Jinbae10/atmega128-drone/BLDC/v1/parts_list.md

# 부품 목록 (BLDC v1, 3S)

- 기준일: 2026-11-06. 소자 값·수량은 회로도 [drone_v1.kicad_sch](drone_v1.kicad_sch) 기준입니다.
- 가격은 디바이스마트 화면 표시 금액이며, 부가세 별도일 가능성이 있습니다. 재고와 가격은 주문 시 다시 확인해야 합니다.
- 칩 크기는 미터 표기(인치 표기)입니다. 예: 2012(0805).

## 1. 구매할 납땜 소자 (디바이스마트)

| 소자 | 값·정격 | 크기 | 필요 수량 | 회로도 번호 | 품목 | 판매 단위 | 가격 |
|---|---|---|---|---|---|---|---|
| 칩저항 | 10k ±1% (F급) | 2012 | 7 | R1, R2, R14, R4~R7 | TA-I | 100개 | 약 500원 |
| 칩저항 | 1k ±5% (J급) | 2012 | 2 | R3, R12 | TA-I | 100개 | 약 500원 |
| 칩저항 | 2k ±5% (J급) | 2012 | 1 | R13 | TA-I | 100개 | 약 500원 |
| 칩저항 | 100Ω ±5% (J급) | 2012 | 4 | R8~R11 | TA-I | 100개 | 약 500원 |
| MLCC | 100nF | 3216 (1206) | 5 | C3~C7 | 미정 | 100개 | 약 1,900원 |
| 폴리퓨즈 | 0.5A 24V | 3216 (1206) | 1 | F1 | FSMD050-24-1206R | 10개 | 약 1,100원 |
| 쇼트키 다이오드 | BAT54 | SOT-23 | 1 | D1 | Diotec (재판매, 5~7일) | 미확인 | 240원 |
| 전해 커패시터 | 100µF 35V | 스루홀 Ø6.3×11mm, 핀 간격 2.5mm | 2 | C1, C2 | 미정 | 10개 | 약 400원 |
| 슬라이드 스위치 | SPDT 약 0.3A | 스루홀 약 8.7×4.5mm, 핀 간격 2.54mm (미확인) | 1 | SW1 | SS-12D02 | 낱개 | 150원 |
| 핀헤더 | 2.54mm 1×40 | 스루홀 | 1줄 (11핀 사용) | J1, J3, U1 장착용 | 미정 | 낱개 | 200원 |

20k 칩저항은 소량 구매가 어려워 10k 두 개를 직렬로 씁니다(R1 + R14).

## 2. 구매할 모듈·기타 (디바이스마트)

| 부품 | 수량 | 크기 | 품목 | 가격 | 비고 |
|---|---|---|---|---|---|
| MPU-6050 GY-521 | 1 | 약 21×16×3mm | | 4,950원 | 10월 17일 가격. 최근 검색 화면은 4,500원 |
| HC-06 DIP 슬레이브 | 1 | 약 37×17mm (미확인) | SZH-EK105 | 6,050원 | 10월 17일 가격. 최근 검색 화면은 5,500원 |
| MP1584 강압 모듈 | 1 | 약 22×17×4mm (패드 간격 미확인) | VLT-VC042 | 1,800원 | 핀헤더로 PCB에 장착 |
| XT60 암수 세트 | 2 | | | 3,200원 | 2세트 합계로 계산함. 주문 시 확인 |
| 14AWG 실리콘 전선 | 1m | | DFROBOT FIT0583 | 약 9,800원 | 모터 전류 경로 |
| 벨크로 타이 | 1 | | SZ-XL036 | 900원 | 배터리 고정 |
| M3 나사 | 100개 | M3×5 확인, 길이는 모터 실측 후 결정 | | 약 1,000원 | 프레임 확인 후 구매 |
| 열수축 튜브 | 소량 | 지름은 전선에 맞춰 선택 | | 미확인 | |
| 3S LiPo | 1 | 미확인 | 1600mAh 65C | 26,000원 | 프레임 무게 확인 후 결정 |

### 디바이스마트 예상 합계 (표시 가격, 판매 단위 기준)

| 구분 | 금액 |
|---|---|
| 1번 표 합계 | 5,990원 |
| 2번 표 합계 (열수축 튜브·배터리 제외) | 27,700원 |
| **소계** | **33,690원** |
| 3S LiPo 포함 | 59,690원 |

배송비 2,700원과 열수축 튜브는 빠져 있습니다.

## 3. 다른 곳에서 구할 것

| 부품 | 구입처 | 비고 |
|---|---|---|
| 3S 밸런스 충전기 | RC 샵 | 디바이스마트 검색에서 못 찾음 |
| 전원 분배 보드 (40A 이상, 4출력) | RC 샵 | ESC 전해가 없거나 16V면 35V 470µF 추가 |
| LiPo 가방 | RC 샵 | |
| 와트미터 50A 이상 | RC 샵 | 권장 품목 |
| PCB 2층 0.8mm | JLCPCB | 설계 완료 후 주문 |
| 프레임 | 학교 3D 프린터 | STL 미선정 |

## 4. 아직 정하지 않은 것

| 항목 | 상태 |
|---|---|
| 플럭스, 핀셋, 솔더윅 | SMD 납땜에 필요. 대여 공구함에 있는지 미확인 |
| 로직 배선 24~26AWG | 실험실 여분 확인. 디바이스마트 26AWG는 60m 키트(22,000원)라 소량용으로 맞지 않음 |
| J1(로직 전원) 커넥터·케이블 | 회로도는 임시로 2.54mm 2핀 헤더 |
| J2(HC-SR04)·J4(HC-06) 연결 케이블 | PCB 쪽이 소켓이므로 모듈 핀과 맞는 4선 케이블 필요 |
| J3(ESC 신호) 연결 케이블 | PCB 쪽이 5핀 헤더. ESC 신호선 끝단 확인 필요 |
| M2 나사·스페이서 | PCB M2 구멍 4개용. 프레임 확정 후 길이 결정 |
| 여분 프로펠러 | 총 8개 권장. 구매 수량 확인 후 결정 |
| 프로펠러 가드 | 미결정 |

## 5. 이미 있는 것 (구매 불필요)

| 부품 | 수량 | 크기 | 상태 |
|---|---|---|---|
| BLDC 모터 2204 | 4 | | 구매 완료 |
| ESC | 4 | | 구매 완료, BEC 미사용 |
| 프로펠러 | 구매 수량 | | 구매 완료 |
| AT128A-70B 모듈 | 1 | 25.4×76.2mm | 대여, 납땜·개조 금지 |
| HC-SR04 | 1 | 약 45×20×15mm (미확인) | 보유 |
| 2.54mm 암헤더 1×40 | 2줄 | 스루홀 | 보유, **수량 확인 필요** (아래 참고) |
| USB JTAG ICE | 1 | | 대여 |
| AR-UART2USB + 케이블 | 1 | | 대여 |
| 납땜 공구 | 1식 | | 대여 |

**암헤더 수량:** 소켓은 29핀 2개(모듈), 8핀 1개(GY-521), 4핀 2개(HC-SR04·HC-06)로 총 74핀이 필요합니다. 자를 때 1칸씩 손실되므로 1×40 1줄에서 29핀+8핀, 다른 1줄에서 29핀+4핀+4핀을 자르면 2줄로 충분합니다(계산값).

## 주문 전 실측·확인

- MP1584(VLT-VC042) 패드 위치, SS-12D02 핀 간격, GY-521 헤더 위치, HC-06 핀 순서: 현재 PCB 풋프린트는 동종 제품 치수를 기준으로 한 값이라 실물과 다를 수 있습니다.
- 3216 MLCC의 전압 정격: 품목을 고르지 않았습니다. C3~C7은 5V 이하 회로에 들어갑니다.
- 2012 저항의 정격 전력: 1/8W는 일반값이며 구매 품목 표기로 확인하지 않았습니다.
- 모터·ESC·프로펠러의 실제 모델: 구매 내역을 보지 못했습니다.
