Jinbae10/atmega128-drone/BLDC/v2/drone_v2_schematic.pdf

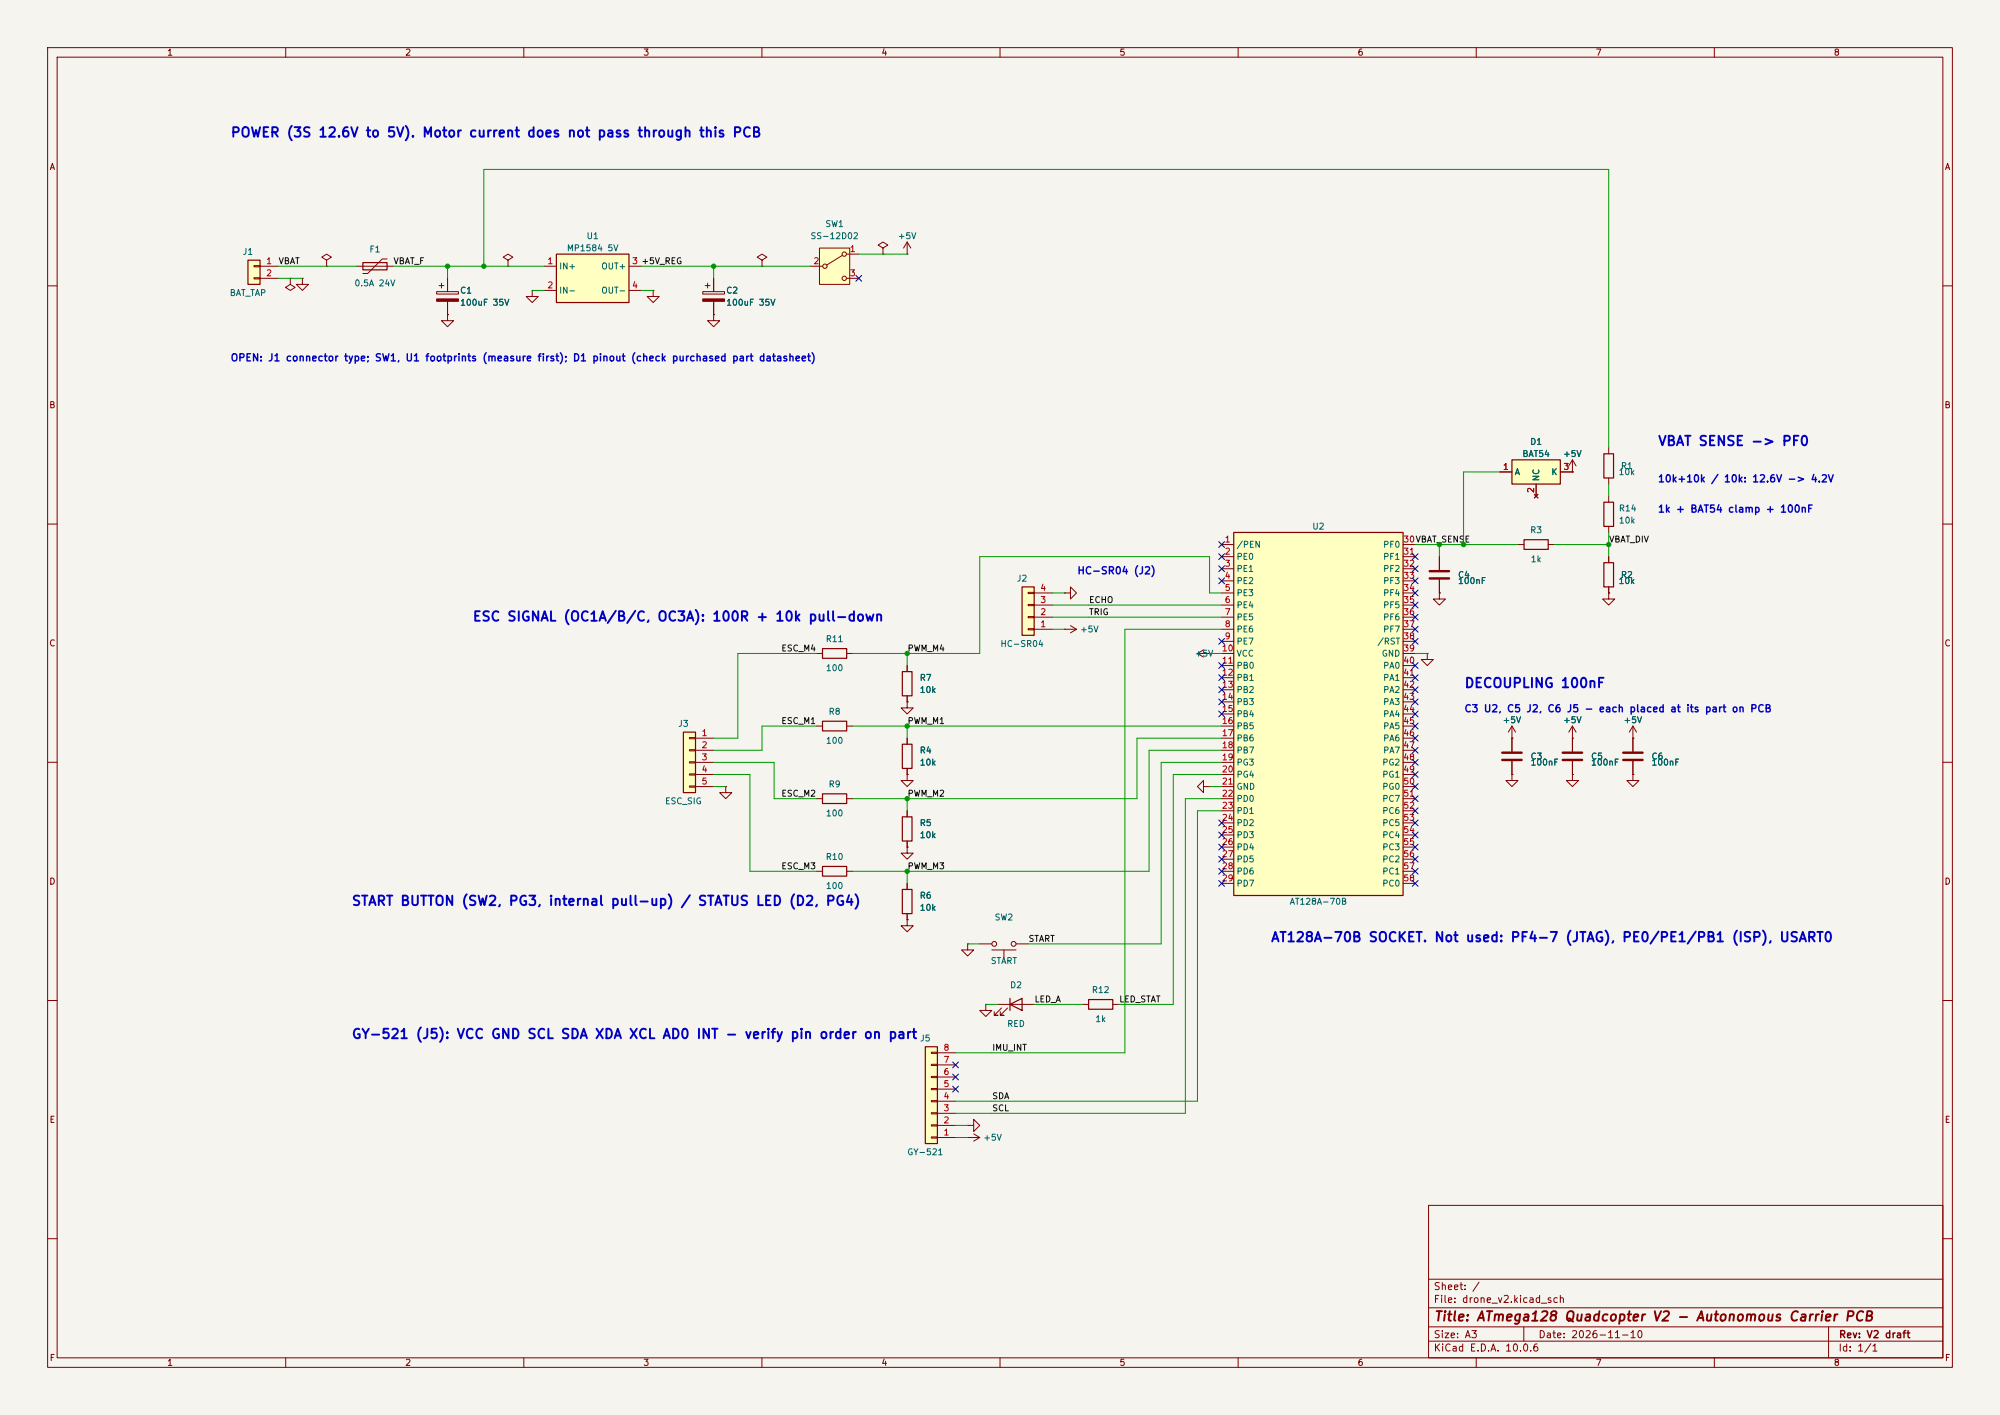
[picture p1: page 1]

POWER (3S 12.6V to 5V). Motor current does not pass through this PCB

OPEN: J1 connector type; SW1, U1 footprints (measure first); D1 pinout (check purchased part datasheet)

ESC SIGNAL (OC1A/B/C, OC3A): 100R + 10k pull-down

C3 U2, C5 J2, C6 J5 - each placed at its part on PCB

START BUTTON (SW2, PG3, internal pull-up) / STATUS LED (D2, PG4)

GY-521 (J5): VCC GND SCL SDA XDA XCL AD0 INT - verify pin order on part

Sheet: /
File: drone_v2.kicad_sch
Title: ATmega128 Quadcopter V2 - Autonomous Carrier PCB

Size: A3 | Rev: V2 draft | F Date: 2026-11-10
KiCad E.D.A. 10.0.6 | Id: 1/1
