Jinbae10/atmega128-drone/BLDC/v1/drone_v1_schematic.pdf

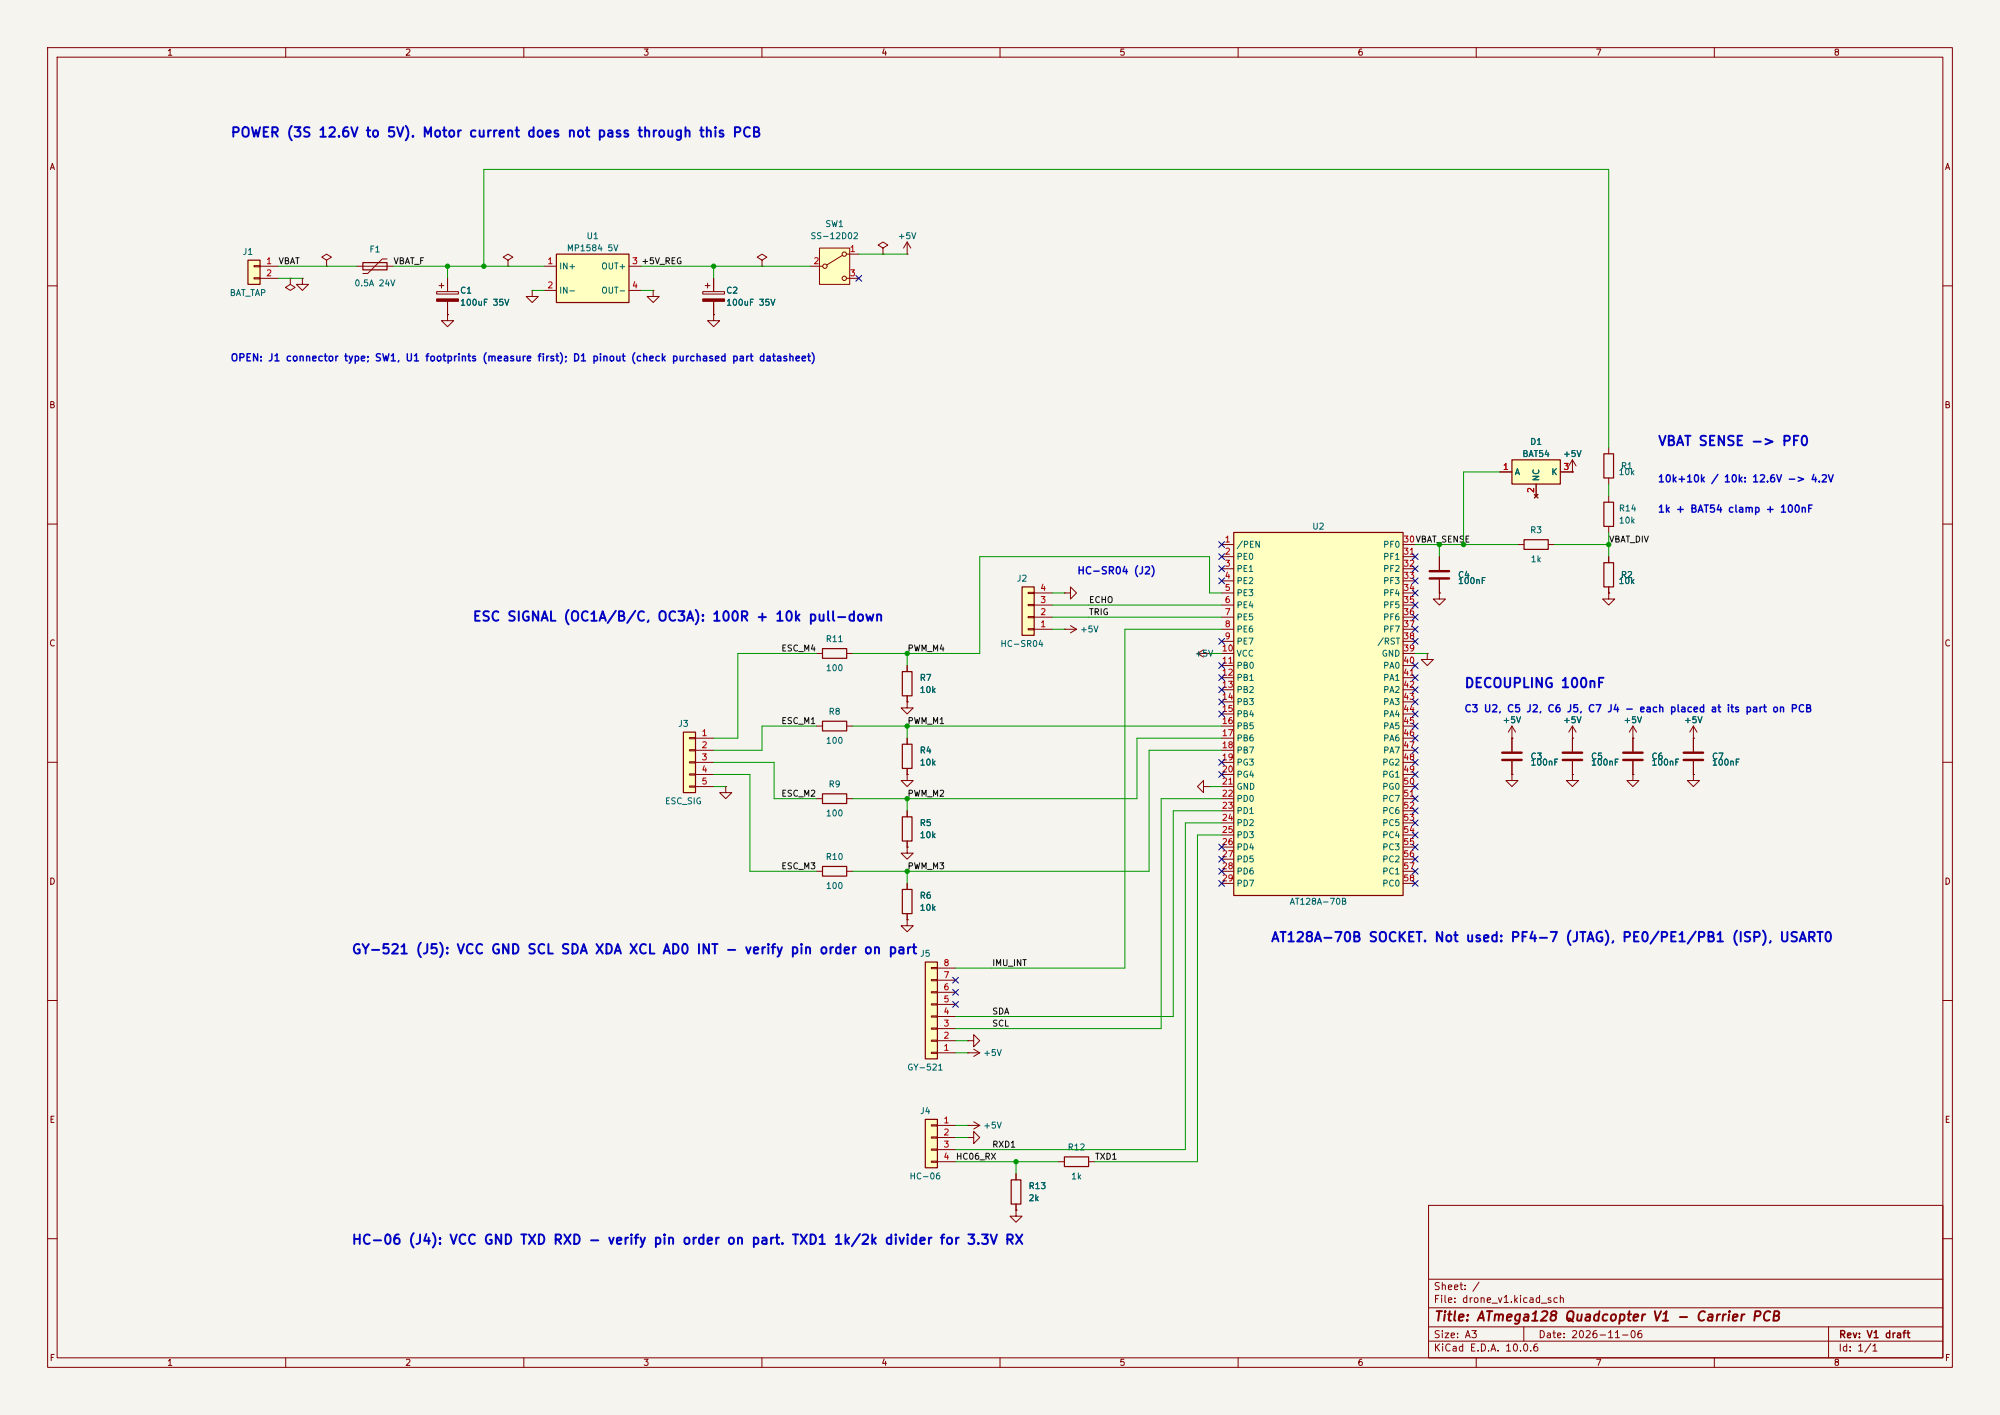
[picture p2: page 1]

POWER (3S 12.6V to 5V). Motor current does not pass through this PCB

OPEN: J1 connector type; SW1, U1 footprints (measure first); D1 pinout (check purchased part datasheet)

ESC SIGNAL (OC1A/B/C, OC3A): 100R + 10k pull-down

C3 U2, C5 J2, C6 J5, C7 J4 - each placed at its part on PCB

AT128A-70B SOCKET. Not used: PF4-7 (JTAG), PE0/PE1/PB1 (ISP), USART0

GY-521 (J5): VCC GND SCL SDA XDA XCL AD0 INT - verify pin order on part

HC-06 (J4): VCC GND TXD RXD - verify pin order on part. TXD1 1k/2k divider for 3.3V RX

Sheet: /
File: drone_v1.kicad_sch
Title: ATmega128 Quadcopter V1 - Carrier PCB

Size: A3 | Rev: V1 draft | F Date: 2026-11-06
KiCad E.D.A. 10.0.6 | Id: 1/1
