Jinbae10/atmega128-drone/BLDC/v2/drone_v2.kicad_pcb

## KiCad design BLDC/v2/drone_v2.kicad_pcb (2026-11-10)

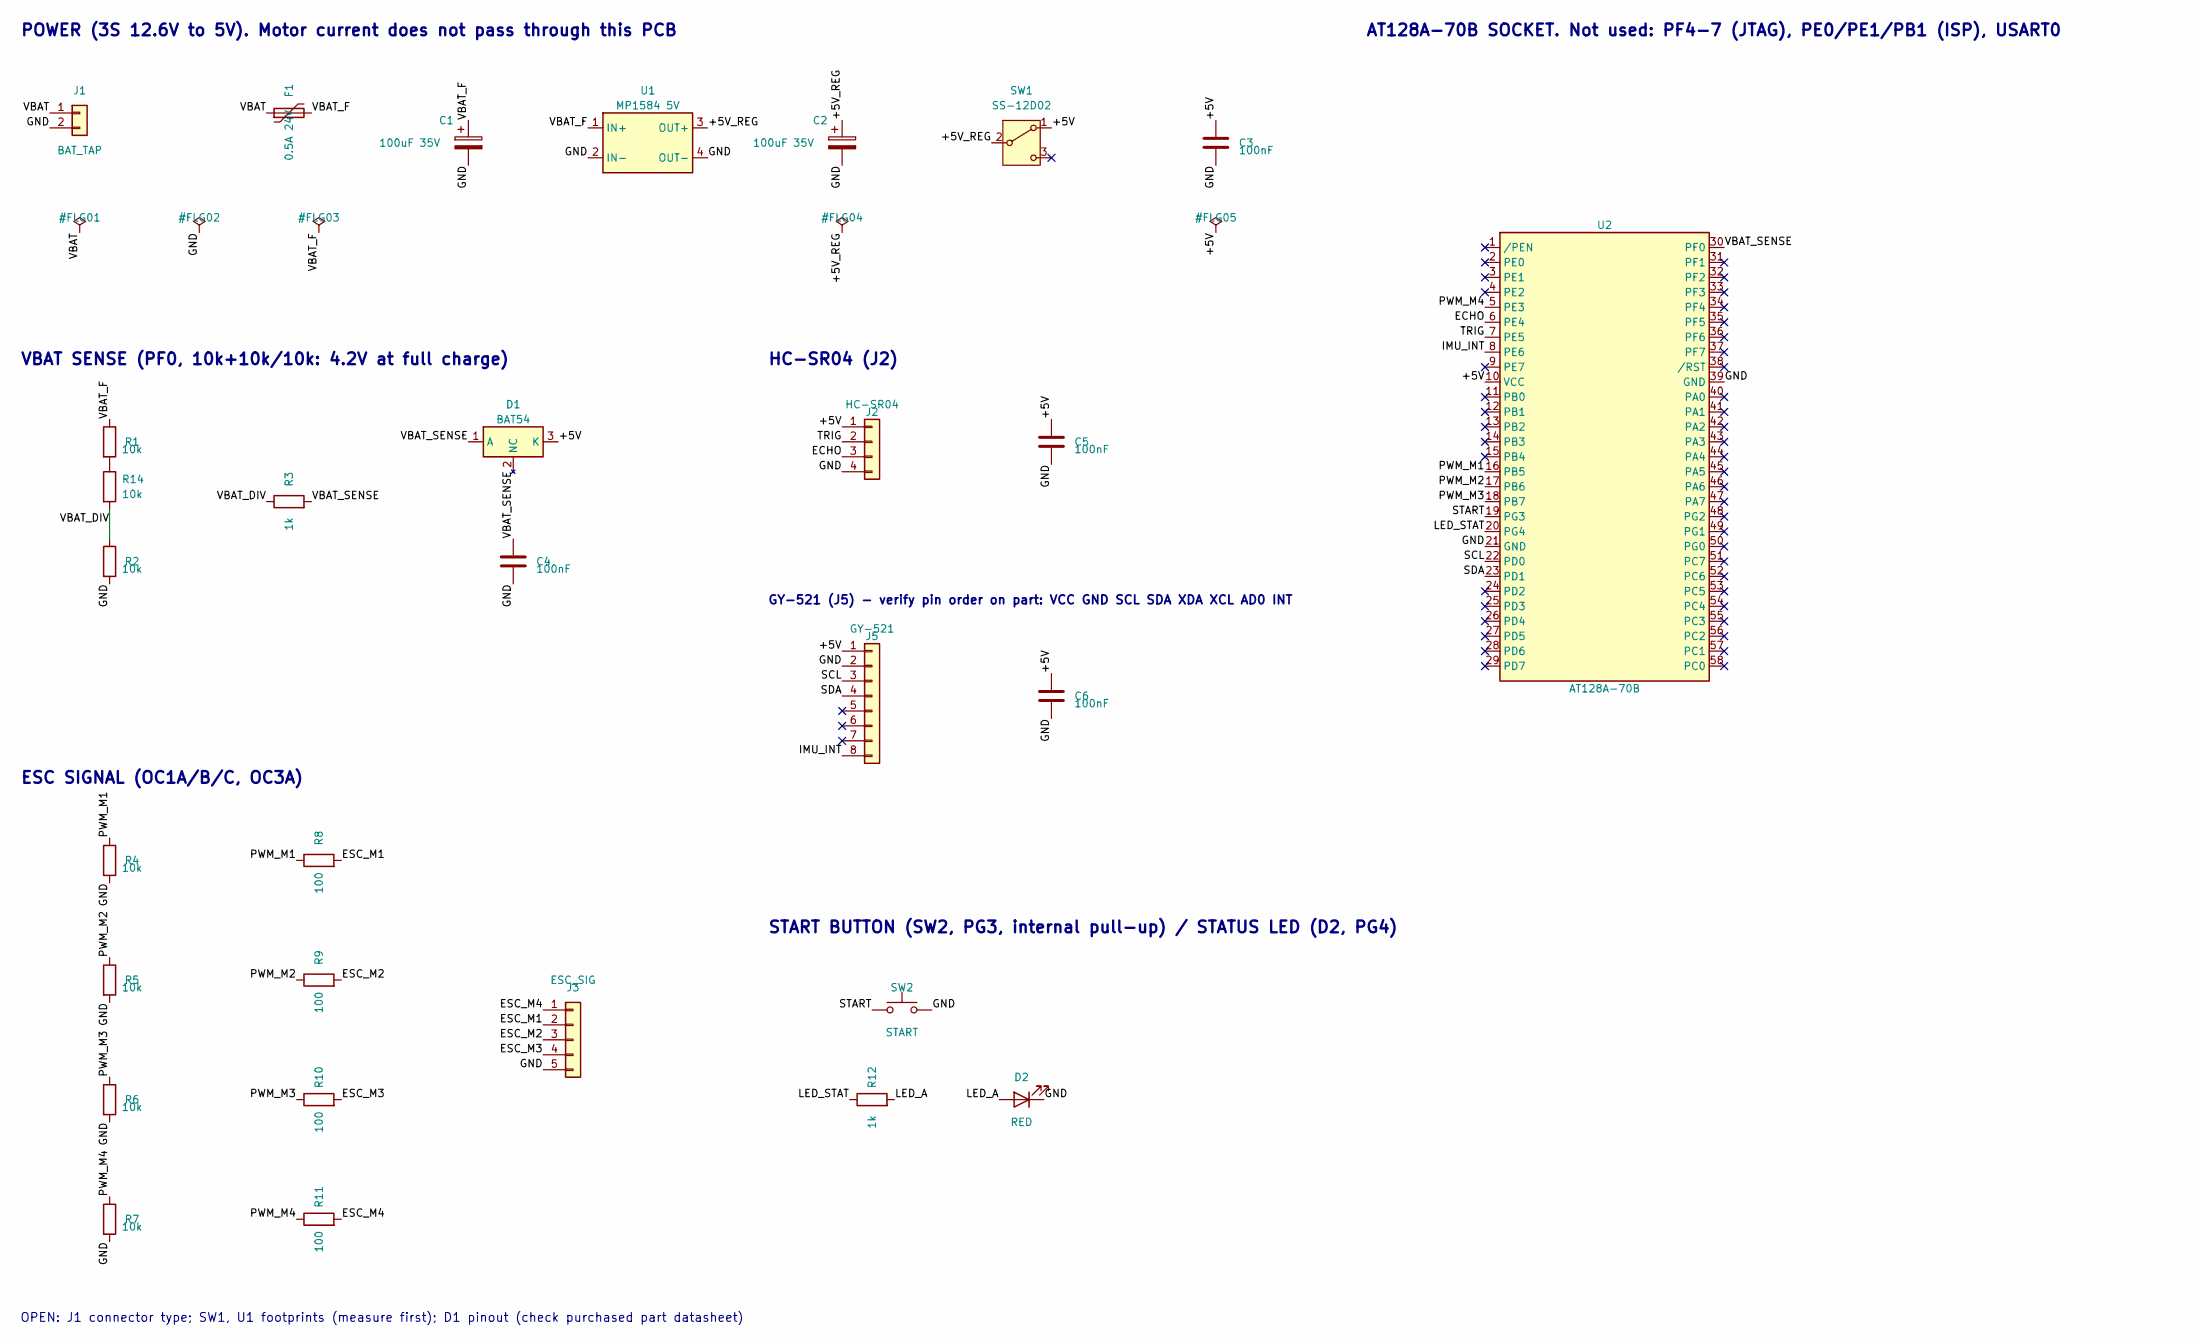
[picture p3: schematic drone_v2.kicad_sch, ATmega128 Quadcopter V2 - Autonomous Carrier PCB]

Parts:
C1, C2: 100uF 35V; CP_Radial_D6.3mm_P2.50mm
C3, C4, C5, C6: 100nF; C_1206_3216Metric_Pad1.33x1.80mm_HandSolder
D1: BAT54; SOT-23
D2: RED; LED_0805_2012Metric_Pad1.15x1.40mm_HandSolder
F1: 0.5A 24V; Fuse_1206_3216Metric_Pad1.42x1.75mm_HandSolder; MPN FSMD050-24-1206R
J1: BAT_TAP; PinHeader_1x02_P2.54mm_Vertical
J2: HC-SR04; PinSocket_1x04_P2.54mm_Vertical
J3: ESC_SIG; PinHeader_1x05_P2.54mm_Vertical
J5: GY-521; PinSocket_1x08_P2.54mm_Vertical
R1, R2, R4, R5, R6, R7, R14: 10k; R_0805_2012Metric_Pad1.20x1.40mm_HandSolder
R3, R12: 1k; R_0805_2012Metric_Pad1.20x1.40mm_HandSolder
R8, R9, R10, R11: 100; R_0805_2012Metric_Pad1.20x1.40mm_HandSolder
SW1: SS-12D02; SW_SS-12D02_P2.54
SW2: START; SW_PUSH_6mm
U1: MP1584 5V; MP1584_Module_22x17
U2: AT128A-70B; AT128A-70B_Socket

Connections:
+5V: C3.1, C5.1, C6.1, D1.3 (K), J2.1, J5.1, SW1.1 (A), U2.10 (VCC)
+5V_REG: C2.1, SW1.2 (B), U1.3 (OUT+)
ECHO: J2.3, U2.6 (PE4)
ESC_M1: J3.2, R8.2
ESC_M2: J3.3, R9.2
ESC_M3: J3.4, R10.2
ESC_M4: J3.1, R11.2
GND: C1.2, C2.2, C3.2, C4.2, C5.2, C6.2, D2.1 (K), J1.2, J2.4, J3.5, J5.2, R2.2, R4.2, R5.2, R6.2, R7.2, SW2.2, U1.2 (IN-), U1.4 (OUT-), U2.21 (GND), U2.39 (GND)
IMU_INT: J5.8, U2.8 (PE6)
LED_A: D2.2 (A), R12.2
LED_STAT: R12.1, U2.20 (PG4)
unnamed: R1.2, R14.1
PWM_M1: R4.1, R8.1, U2.16 (PB5)
PWM_M2: R5.1, R9.1, U2.17 (PB6)
PWM_M3: R6.1, R10.1, U2.18 (PB7)
PWM_M4: R7.1, R11.1, U2.5 (PE3)
SCL: J5.3, U2.22 (PD0)
SDA: J5.4, U2.23 (PD1)
START: SW2.1, U2.19 (PG3)
TRIG: J2.2, U2.7 (PE5)
VBAT: F1.1, J1.1
VBAT_DIV: R2.1, R3.1, R14.2
VBAT_F: C1.1, F1.2, R1.1, U1.1 (IN+)
VBAT_SENSE: C4.1, D1.1 (A), R3.2, U2.30 (PF0)

Notes on the sheet:
POWER (3S 12.6V to 5V). Motor current does not pass through this PCB
VBAT SENSE (PF0, 10k+10k/10k: 4.2V at full charge)
ESC SIGNAL (OC1A/B/C, OC3A)
HC-SR04 (J2)
GY-521 (J5) - verify pin order on part: VCC GND SCL SDA XDA XCL AD0 INT
AT128A-70B SOCKET. Not used: PF4-7 (JTAG), PE0/PE1/PB1 (ISP), USART0
OPEN: J1 connector type; SW1, U1 footprints (measure first); D1 pinout (check purchased part datasheet)
START BUTTON (SW2, PG3, internal pull-up) / STATUS LED (D2, PG4)

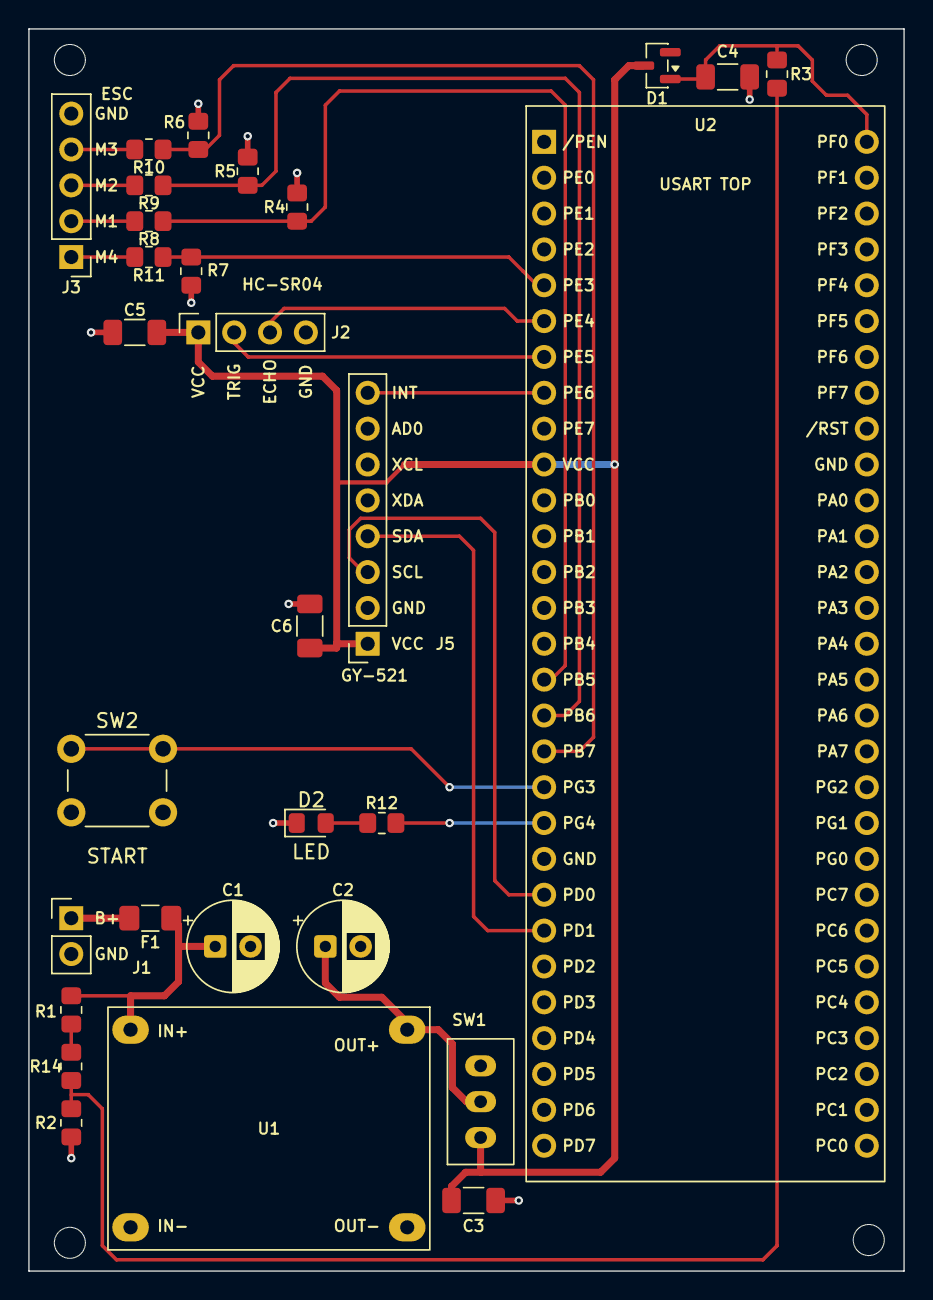
[picture p4: board drone_v2.kicad_pcb from above]

Board: 2 copper layers, 62.0 x 88.0 mm, 34 parts (0 on the bottom side), 24 nets.

Other parts of the board:
MH1, MH2, MH3, MH4: MountingHole_2.2mm; MountingHole_2.2mm_M2
