Jinbae10/atmega128-drone/(commit log)

2026-10-29 초기 커밋: 드론 텀 프로젝트 설계 자료 (KiCad DC v0–v3, BLDC, 문서·발표)
    [8250_Frame_v7.stl, drone_bldc.kicad_pcb, drone_bldc.kicad_sch, drone_dc.kicad_pcb, drone_dc.kicad_sch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]
2026-11-05 브러시드 DC PCB 프로젝트 삭제 (BLDC 전환)
    [drone_dc.kicad_pcb, drone_dc.kicad_sch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]
2026-11-05 문서 갱신: BLDC 전환 반영, 삭제된 DC 경로 참조 제거
2026-11-05 프로젝트 폴더 정리: 데이터시트 이동, BLDC v0·v1 추가, CLAUDE.md 최신화
    - 데이터시트를 datasheet/로 옮기고 이름 변경
    - BLDC 프로젝트를 BLDC/v0으로, 블록도·PCB 스케치를 BLDC/v1로 정리
    - 블록도의 철회된 5m 유선 표기를 AR-UART2USB 유선 백업 기준으로 수정
    - drone_term_project.md의 유효한 내용을 CLAUDE.md로 통합 후 삭제
    - 옛 발표 자료, 대본, 스케치, 프레임 STL 삭제
    [8250_Frame_v7.stl, drone_bldc.kicad_pcb, drone_bldc.kicad_sch]
2026-11-05 CLAUDE.md에서 브러시드 DC 모터 관련 내용 삭제
2026-11-06 BLDC v1 회로도·PCB 설계, 2204 3S 반영
    - drone_v1 KiCad 프로젝트 추가: 회로도, 42×88mm 2층 PCB, 수동 배선
    - 부품 목록 parts_list.md 추가, 블록도를 3S 기준으로 수정
    - CLAUDE.md에 구동계·VBAT 분압·배치·결정 기록 반영
    풋프린트 일부는 실측 전이라 주문하지 않음.
    [drone_v1.kicad_pcb, drone_v1.kicad_sch]
2026-11-07 PCB v1 62×88mm 재설계, 트랙 90도 모서리 45도 모따기
    - AT128A-70B 1×29 소켓 2줄이 들어가도록 62×88mm로 재설계, 수동 배선
    - 90도 모서리 42곳 모따기(패드 안 꺾임 3곳과 T 분기는 유지)
    - 거버·드릴 시안 재출력, CLAUDE.md 규칙·결정 기록 갱신
    - DRC 오류 0, 미연결 0. 실측 전이라 주문하지 않음
    [drone_v1-B_Cu.gbl, drone_v1-B_Mask.gbs, drone_v1-B_Silkscreen.gbo, drone_v1-Edge_Cuts.gm1, drone_v1-F_Cu.gtl, drone_v1-F_Mask.gts, drone_v1-F_Silkscreen.gto, drone_v1-NPTH.drl]
2026-11-07 PCB v1 그림 추가, 블록도 모듈 헤더 표기 수정
    - images/: 3D 렌더 앞·뒷면, 동박면 앞·뒷면 PNG
    - 블록도: 암헤더 1×15 ×4 → 1×29 ×2
2026-11-08 BLDC v0 삭제
    v1로 대체되어 불필요. 필요하면 8f1139c에서 복구.
    [drone_bldc.kicad_pcb, drone_bldc.kicad_sch]
2026-11-10 PCB v2 추가: HC-06 제거, 시작 버튼·상태 LED로 자율 비행판
    - BLDC/v2: v1 복사 후 J4·R12(분압)·R13·C7 제거, RXD1/TXD1 배선 삭제
    - SW2 6mm 택트(PG3, 내부 풀업), D2 0805 LED + R12 1k(PG4) 추가
    - PG3/PG4는 비아 + 뒷면 짧은 트랙으로 연결, ERC·DRC 오류 0
    - CLAUDE.md 현재 상태·파일 구성·결정 기록 갱신
    [drone_v2.kicad_pcb, drone_v2.kicad_sch]
2026-11-10 회로도 v1·v2를 연결선으로 재작성, 노션 작업 보드 문구 삭제
    - 넷 라벨만 쓰던 회로도를 U2 중심 배치 + 연결선으로 다시 그림
    - GND·+5V만 전원 심볼, 신호 넷 이름·연결은 그대로(넷리스트 동일, ERC 오류 0, PCB 패리티 오류 0)
    - 회로도 PDF 재출력
    - CLAUDE.md: 결정 기록 추가, 노션 구조에서 작업 보드 문구 삭제
    [drone_v1.kicad_sch, drone_v2.kicad_sch]
